Jimzjy/ECAT-SIGMA-X/model/ECAT_M_BTN.SLDPRT

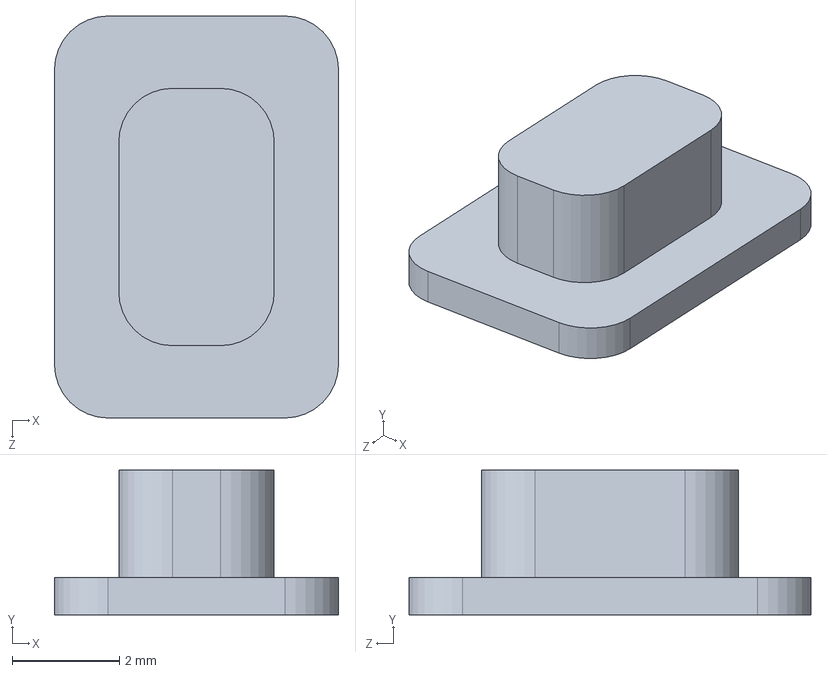
[picture p1: CAD file, 2026-11-03]
model/ECAT_M_BTN.SLDPRT
5.30 x 2.70 x 7.50 mm
