Jimzjy/ECAT-SIGMA-X/model/ECAT_M.SLDPRT

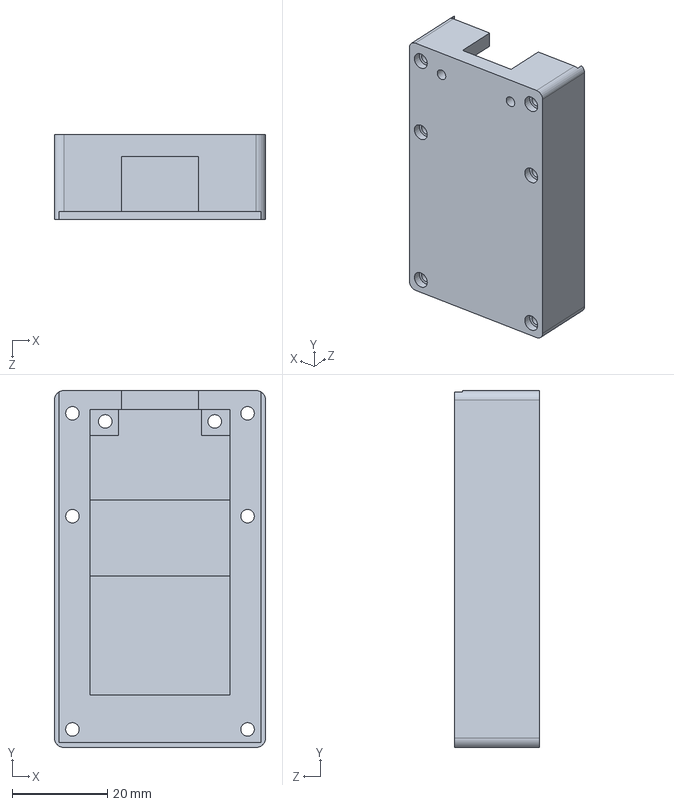
[picture p2: CAD file, 2026-11-03]
model/ECAT_M.SLDPRT
44.4 x 75.0 x 17.9 mm
