Jimzjy/ECAT-SIGMA-X/model/ECAT_M_中间隔板.SLDPRT

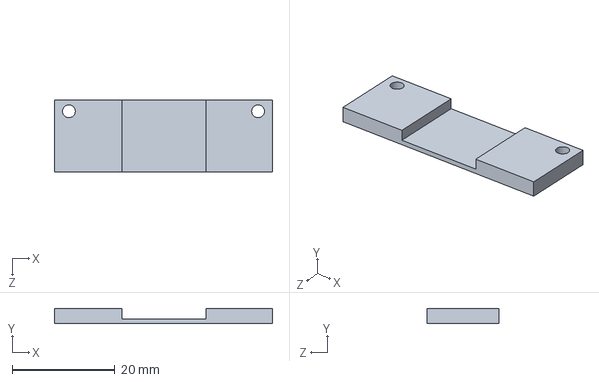
[picture p3: CAD file, 2026-11-03]
model/ECAT_M_中间隔板.SLDPRT
42.3 x 2.90 x 14.0 mm
