Jimzjy/ECAT-SIGMA-X/model/ECAT_M_TOP.SLDPRT

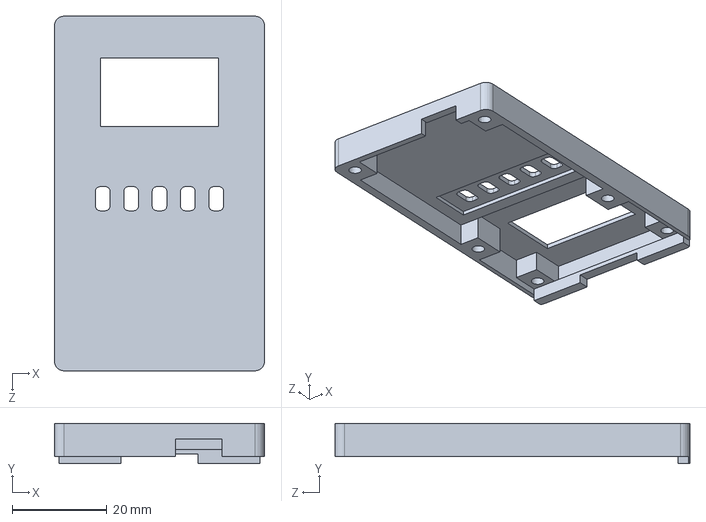
[picture p4: CAD file, 2026-11-03]
model/ECAT_M_TOP.SLDPRT
44.4 x 8.50 x 75.0 mm
