Jimzjy/ECAT-SIGMA-X/model/装配体1.SLDASM

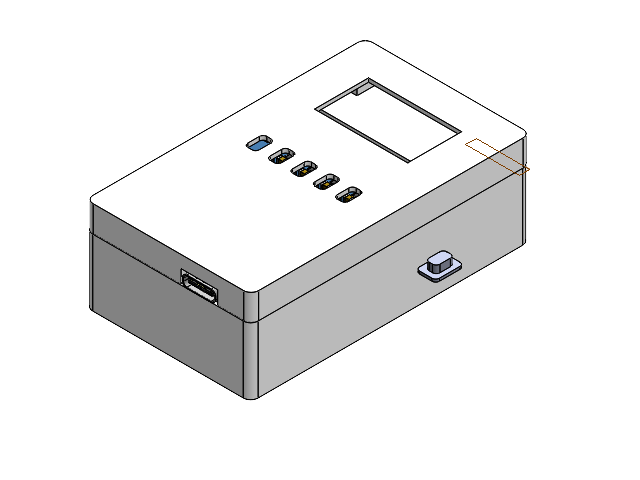
[picture p6: CAD file, 2026-11-03]
model/装配体1.SLDASM
ECAT_M_中间隔板
ECAT_M
SW-SMD_L6.0-W3.5-LS8.0-1~SW-SMD_L6.0-W3.5-LS8.0-1~ne9q.step x 5
R0805~R0805_L2.0-W1.3-H0.6~Ix6e.step x 8
MSOP-10_L3.0-W3.0-P0.50-LS5.0-BL~MSOP-10_L3.0-W3.0-H1.1-LS5.0-P0.50~C4Me.step
SOD-123FL_L2.8-W1.8-LS3.7-BI~SOD-123FL_L2.8-W1.8-LS3.7-BI~3kmw.step
C0805~C0805_L2.0-W1.3-H1.3~A3NU.step x 16
SOT-23-5_L2.9-W1.6-P0.95-LS2.8-BR~SOT-23-5_L2.9-W1.6-P0.95-LS2.8-BR~8vHh.step
OSC-TH_L10.0-W4.5-P5.00~HC-49US_L11.0-W4.5-H3.5-P4.88~HHTd.step
USB-C-SMD_KH-TYPE-C-16P~USB-C-SMD_KH-TYPE-C-16P~kQrI.step
LQFP-48_L7.0-W7.0-P0.50-LS9.0-BL~LQFP-48_L7.0-W7.0-H1.4-LS9.0-P0.50~X3Li.step
Board~H2Km.step
ECAT_M_TOP
ECAT_M_BTN
