Jimzjy/ECAT-SIGMA-X/Core/Inc/main.h

#define BTN_CONFIRM_Pin GPIO_PIN_5
#define BTN_CONFIRM_GPIO_Port GPIOA
#define BTN_CONFIRM_EXTI_IRQn EXTI9_5_IRQn
#define BTN_SELECT_Pin GPIO_PIN_6
#define BTN_SELECT_GPIO_Port GPIOA
#define BTN_SELECT_EXTI_IRQn EXTI9_5_IRQn
#define BTN_DOWN_Pin GPIO_PIN_7
#define BTN_DOWN_GPIO_Port GPIOA
#define BTN_DOWN_EXTI_IRQn EXTI9_5_IRQn
#define BTN_UP_Pin GPIO_PIN_0
#define BTN_UP_GPIO_Port GPIOB
#define BTN_UP_EXTI_IRQn EXTI0_IRQn
#define BTN_BACK_Pin GPIO_PIN_1
#define BTN_BACK_GPIO_Port GPIOB
#define BTN_BACK_EXTI_IRQn EXTI1_IRQn
