Jimzjy/ECAT-SIGMA-X/(commit log)

2026-02-10 基本功能完成
2026-11-03 完善 README（手持配置器说明），新增 JH800-Y 参数预设，补充 EDA/结构设计文件
    [3D_PCB1_2026-02-11.SLDASM, ECAT_M.SLDPRT, ECAT_M_BTN.SLDPRT, ECAT_M_TOP.SLDPRT, ECAT_M_中间隔板.SLDPRT, 装配体1.SLDASM]
2026-11-03 许可改为 MIT，补充 LICENSE 文件
